mareths/suisTesAbeilles/README.md

# suisTesAbeilles

Adresse du Trello: [https://trello.com/b/HOREakGQ/suistesabeilles](https://trello.com/b/HOREakGQ/suistesabeilles)
