mareths/suisTesAbeilles/Fritzing/SuisTesAbeilles_bb.jpg

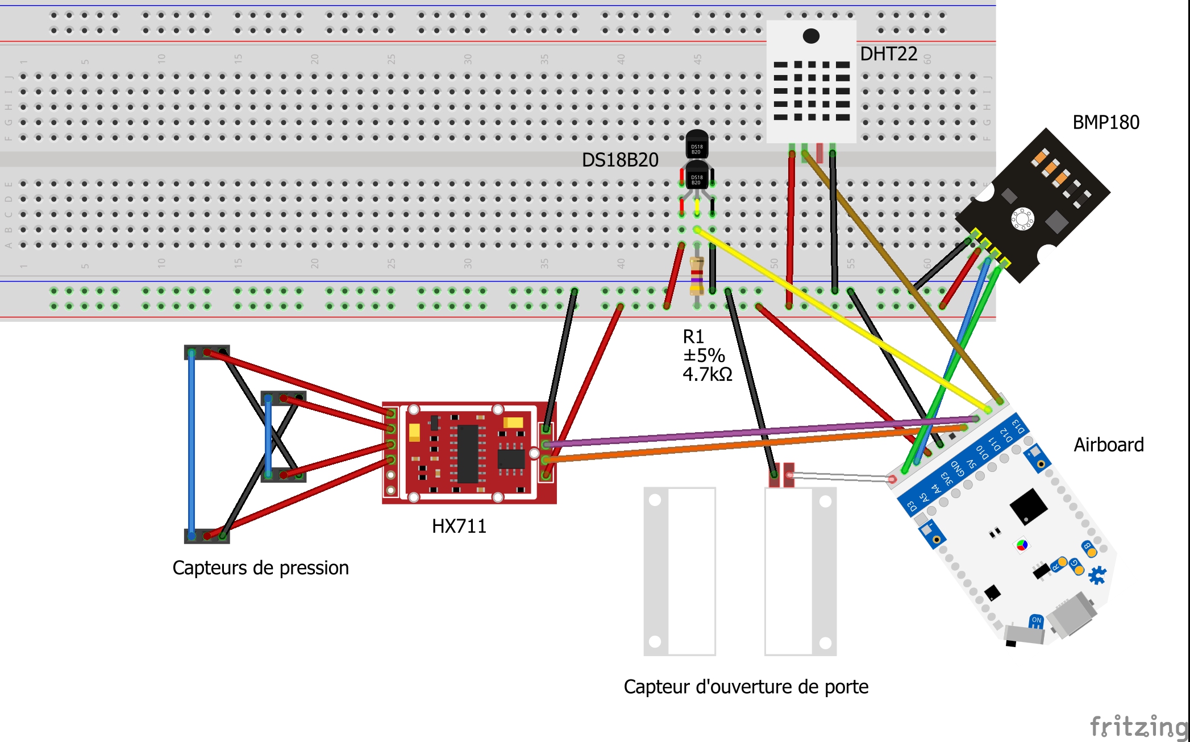
Fritzing/SuisTesAbeilles_bb.jpg
