mareths/suisTesAbeilles/sources/example/nRF24L01+/pingPong/nRF24L01+_bb.jpg

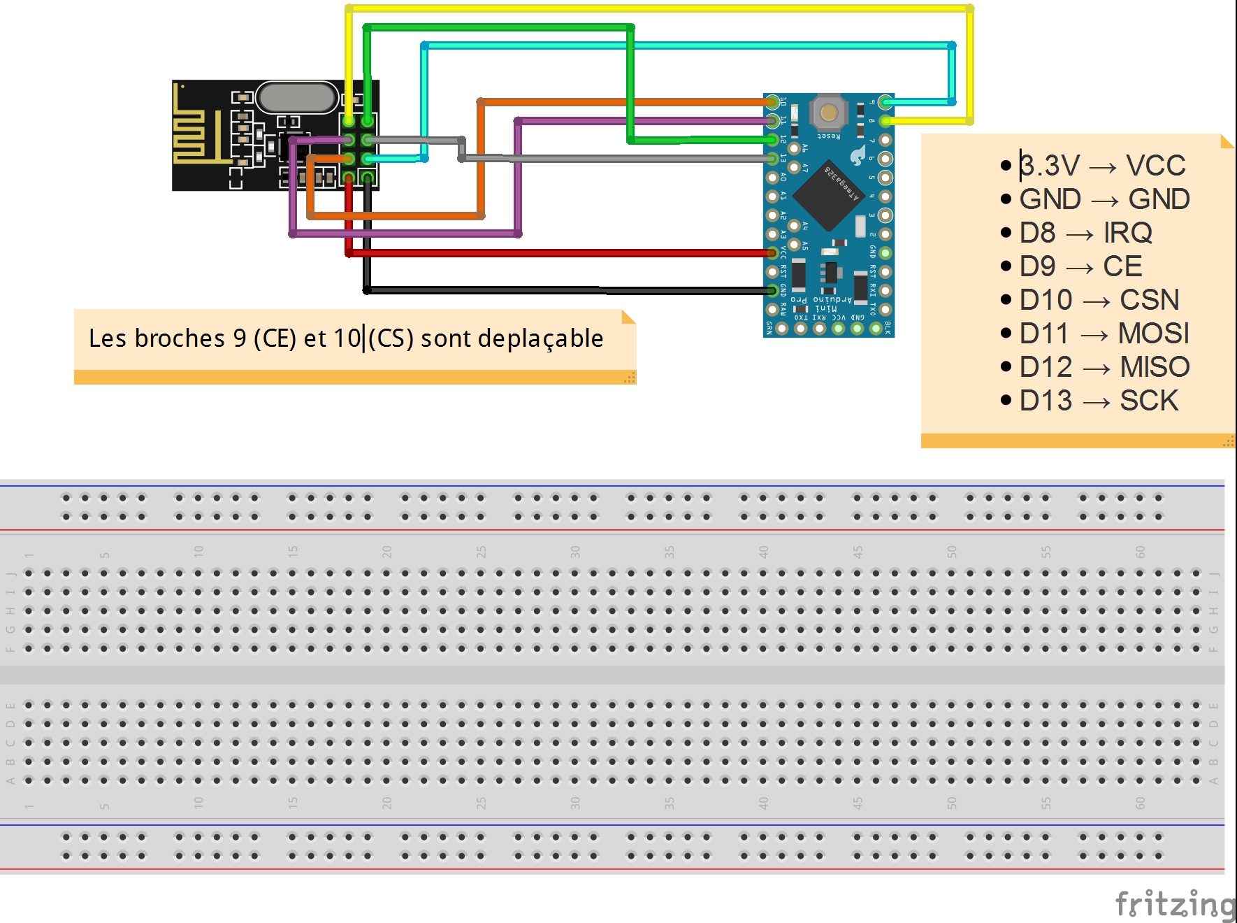
sources/example/nRF24L01+/pingPong/nRF24L01+_bb.jpg
