mareths/suisTesAbeilles/(threads)

Thread 1 (2016-10-16):

Ajouter les reférences des composants dans le schéma

mareths, 2016-10-16:
Il faudrait ajouter les références des composants dans le schéma Fritzing

mareths, 2016-10-16:
Ajout d'un peu plus d'infos sur les composants, à valider :)

ouvriere, 2016-10-16:
validé! Parfait, Champion!

Closed 2016-10-16.

Thread 2 (2016-10-16):

Pins inexactes dans le fichier poids_4LC.ino

mareths, 2016-10-16:
Dans le fichier [poids_4LC.ino](https://github.com/mareths/suisTesAbeilles/blob/master/sources/poids/poids_4LC.ino), peux-tu adapter les 2 pins en entrés aux pins Digital 10 et 11 conformément au schéma de câblage.

ouvriere, 2016-10-16:
programme modifié pour correspondre au schema

Closed 2016-10-16.

Thread 4 (2016-10-30):

Temperature negative

ouvriere, 2016-10-30:
est ce que c bien pris en compte sur l'ensemble des capteurs?

mareths, 2016-10-30:
Evolution à prendre en compte:
Pour le byte décrivant la partie entière de la température, n'utiliser que les 7 bits les plus à droite pour la valeur, et le 8ème bit le plus à gauche pour la partie négative ou positive de la température (1 = positif, 0 = négatif)

Dans le codec de décodage, trouver une formule, un algo permettant la bonne interprétation de cette température

mareths, 2016-11-11:
Test a réaliser:
Mettre Airboard+Lora+un capteur de température dans un congel, relever la T° au moment de la mesure, et relever la mesure reçue par la plateforme

ouvriere, 2016-11-12:
test fait, les capteurs rapportent une température négative.
cf dashboard 11h55

Closed 2016-11-12.

Thread 5 (2016-10-30):

detections des ds18b20 hors boot

ouvriere, 2016-10-30:
il serait bien que la détection des capteurs soit fait à chaque transmission de données?

mareths, 2016-10-30:
Comprends pas :(

ouvriere, 2016-10-30:
le soucis c que si un capteur est mal connecte, si on le reconnecte, il n est pas detecte, aucune mesure de remonte.
Il faut rebooter l arduino. docn j imagine qu il serait peut etre mieux de faire de detection a chaque prise de mesure... c couteux?

mareths, 2016-11-11:
Je pense que c'est coûteux, mais ça se tente.
Pour rester propre, on va coder une fonction reset qui refait l'init des capteurs seulement (voir le module Lora ?)
On garde la fonction setup pour la premiere initialisation.
Il faudra vérifier que ces re-init sont robustes au rejeu pour chaque capteurs

ouvriere, 2016-11-12:
je te propose de laisser tomber et de reouvrir si vraiment il y a un soucis lors de l exploitation.

Thread 6 (2016-10-30):

ds18b20 absent mais capture des mesures qd meme

ouvriere, 2016-10-30:
Done
Unable to find address for Device 2
Go to sleep
[...]
DS18B20 sensor - temperatureDS18B20_1: 2075 - 8 27
DS18B20 sensor - temperatureDS18B20_2: 2100 - 8 52
DS18B20 sensor - temperatureDS18B20_3: 2100 - 8 52

mareths, 2016-10-30:
Il y a juste 3 capteurs DS18B20, et le programme téléverser est identique à celui de la branche master ?

mareths, 2016-10-30:
C'est toujours le device 2 qui donne pas son adresse ? Il faudrait televerser le programme en mode ds18b20_1 (decommente en début de programme le define correspondant et commenté le define ds18b20_3) puis ne l'exécuter qu'avec une des 3 spndss

ouvriere, 2016-10-30:
le use case: j ai deux capteurs de connectés mais 3 dans le code. Forcement, un des 3 ne doit rien renvoyer.
1- c est le 2 qui n est pas détecté (donc 1 et 3 sont détectés), on s attend plutot à 1 et 2 et 3 non detecté (mais c pas ce qui me gêne)
2 - qd, il y a deux capteurs physique de connectés mais le code remonte des mesures pour les 3 capteurs, pourquoi il n y en a pas un sur les 3 capteurs à 0?

mareths, 2016-11-11:
Il faut flaguer les ds18b20 à "détecté" ou "absent" au moment de l'appel à **sensors.getAddress**, et lors de la collecte des la température, fixer celle-ci à "100" pour ceux qui n'ont pas été détecté.

mareths, 2016-11-14:
Ca compile, à tester

ouvriere, 2016-11-15:
ca marche

Closed 2016-11-15.

Thread 7 (2016-10-30):

bpm180 ne repond pas -> prog ko

ouvriere, 2016-10-30:
l initialisation ou la collecte des données bloque si le capteur ne repond pas

mareths, 2016-10-30:
dans le setup(), après:

```
// ---------------------------------------------------------------------
// BMP180 init
// ---------------------------------------------------------------------

    Wire.begin();
    bmp180.calibration();

```
peux-tu rajouter un

`delay(10000)`

ouvriere, 2016-11-06:
ca ne change rien

Thread 8 (2016-10-30):

Ajout des codecs objenious

mareths, 2016-10-30:
Il faudrait ajouter les codecs créés dans objenious, dans un répertoire "code", avec un sous repetoire par codec, contenant le json, et un fichier readme.txt décrivant le reste de la conf pour ce codec.

Lors d'ouverture d'issue concernant les codecs, nous pourrons ainsi les référencer, et faire un peu de ménage sur la plateforme objenious.

Closed 2016-11-12.

Thread 10 (2016-11-07):

urgent : récuperer le niveau de la batterie

ouvriere, 2016-11-07:
mettre à jour le code pour que le niveau de batterie remonte dans les métriques

ouvriere, 2016-11-11:
code modifié, a vérifier...

mareths, 2016-11-14:
Ton code ne prends pas en compte __AVR_ATmega328P__ qui correspond à l'arduino UNO et apparemment le airboard aussi
Source:
http://electronics4dogs.blogspot.fr/2011/01/arduino-predefined-constants.html
https://www.seeedstudio.com/The-AirBoard---prototyping-platform-For-IoT-p-2602.html#

mareths, 2016-11-14:
Peux-tu tester avec ce code ?
http://arduino.stackexchange.com/questions/23526/measure-different-vcc-using-1-1v-bandgap

ouvriere, 2016-11-15:
en cours de test

mareths, 2016-11-15:
A retester

ouvriere, 2016-11-16:
en cours de test
ca semble remonter la meme valeur que precedemment
une led verte s allume lors de la prise de mesure.

ouvriere, 2016-11-27:
au voltmètre
sur broche 3.3v: 2.92v
sur la broche 5v: 3.22v
sur la batterie: 3.81v

ouvriere, 2016-11-27:
avec la fct theairboard 3.19v

Thread 11 (2016-11-09):

allumage de diodes a l initialisation de programme

ouvriere, 2016-11-09:
sans debug, il est compliqué de savoir si le module a accroche le reseau, si le programme est bloque ou s il s est correctement initialise.
il faudrait au minimum une diode pour dire que le module est connecte au reseau
une diode pour la fin de l initialisation sans erreur du programme

ouvriere, 2016-11-11:
code modifié,
1 lumiere verte si connecté au reseau
1 lumiere rouge si non connecté au reseau
1 lumiere verte si setup ok

Closed 2016-11-11.

Thread 15 (2016-11-09):

dependance de la lib dht22 v1.3.0

ouvriere, 2016-11-09:
si on utilise la version 1.3.0 de la lib pour le dht22, il faut la libraire commune
https://github.com/adafruit/Adafruit_Sensor
a documenter dans le code

ouvriere, 2016-11-11:
doc ajoute dans le .ino

Closed 2016-11-11.

Thread 17 (2016-11-12):

intégrer un capteur de vibration

ouvriere, 2016-11-12:
afin de capteur les vibrations des abeilles pour en tirer un "état d'esprit" de la colonie.

mareths, 2016-11-12:
Capteur sonore plutôt non ?

Qu'elle est le type de données envoyés du coup ? Il ne faut pas que cela soit trop lourd à rentrer dans le message.

"l'état d'esprit" de la colonie est-il variable au cours de la journée ? faudra-t-il réaliser plus de mesures que ce qui est actuellement prévue (4/jours) pour avoir cette données ? (eventuellement, remonter l'info à part des autres données collectées).

A rajouter quand on passera sur un arduino mini pro, avec plus d'entrée, car là on est full :)

ouvriere, 2016-11-12:
peut être, sonore, on risque d avoir les bruits parasite de la nature...
sous forme de fréquence Hertz.
oui, il peut l être. par exemple causé par un dérangement, s il est ponctuel, pas trop de soucis, s il dure c plus grave, déduction d'une colonie en stresse.
même fréquence, quelques fois dans la journée. je pense globalement à toutes les 2 heures (versus 4/J), tant que ça rentre dans la taille du message, dans la fréquence.

Thread 18 (2016-11-12):

id inconnus qui remontent

ouvriere, 2016-11-12:
cf kibana des messages arrivent avec un id inconnu et qui peut etre négatifs....... ca sort d où???
si cette nuit ca tourne, ca signifie que ce n est pas dû à une décharge de la batterie

ouvriere, 2016-11-19:
depuis que la frequence d envoi des messages a été diminuée, le phenomene n apparait plus.

Closed 2016-11-19.

Thread 19 (2016-11-12):

améliorer l'intégration d'une nouvelle métrique

ouvriere, 2016-11-12:
Lorsque j ai du ajouter la metrique pour la batterie, j ai du incrementer chaque msg[x] de toutes les métriques car j ai du l ajouter en premiers. les derniers sont pour les ds18b20 et selon le nombre, le tableau change de grandeur. il a fallu une certaine rigueure...
il faudrait améliorer le code pour ajouter la métrique à la fin et limiter l'impact dans le code et les autres métriques.

mareths, 2016-11-12:
J'ai une piste pour générer le code automatiquement, que je dois étudier ;)

Thread 20 (2016-11-15):

Utiliser le downlink pour récupérer les mesures à la demande

ouvriere, 2016-11-15:

ouvriere, 2016-11-16:
Entre deux tempos, on voudrait peut être récupérer un lot de mesure, a un instant t, a la demande. On enverrait un downlink (via le site d'objenious) afin de reveiller l airboard pour qu'il envoie le lot.
De plus, possible d envoyer un downlink qui reinitialiserait l airboard, un reboot?

Thread 21 (2016-11-16):

lors du demarrage, envoyer un premier paquet de mesures

ouvriere, 2016-11-16:
lorsqu on demarre l airboard ou qu il y a une initialisation, il faudrait envoyer un premier lot de mesure.
ca permet de valider que c opérationnel, d avoir immediatement un premier lot d indicateurs au lieu d attendre la premiere tempo qui peut etre de plusieurs heures.

mareths, 2016-11-20:
A tester

ouvriere, 2016-11-26:
testé ok

Closed 2016-11-26.

Thread 22 (2016-11-16):

memoire faible lorsque l on active le debug

ouvriere, 2016-11-16:
depuis l insertion du code pour l issue #6 .
je copierais le message exact la prochaine fois.

mareths, 2016-11-19:
On va être limité en termes de fonctionnalités, va falloir faire des concessions :)
Je vais regarder pour optimiser le code, faudrait voir si il existe pas d'autres librairies pour les différents composants moins lourdes

Thread 23 (2016-11-19):

aucune donnée remontée depuis presque 24h, diode verte clignotante

ouvriere, 2016-11-19:
aucune données remontées depuis 11h55 hier le 18/11. pas de log sur la console objenious.
une led verte clignotée sur l airboard.
Arret/relance de l airboard effectué à 9h18. la diode ne clignote plus. Trace de logs dans la console objenious. en attente de reception d'une donnée (environ 1h apres l'A/R)
Une idée?

ouvriere, 2016-11-19:
donnees envoyées par l airboard a 10h19.
le codec du capteur dans la console objenious a été modifié en "kit de dev" -> le payload n a pas ete decode -> message non renvoyé vers notre serveur grafana/kibana.
ca fait la seconde fois que je contaste cette modif au niveau du codec -> envoyer un mail a objenious!
Reste que "une idee pour la diode clignotante?"

ouvriere, 2016-11-19:
suite au reboot de 10h19, sur 6 envoies de metriques, on en a perdu 2 (trou de deux heures dans les graphes).
rollback sur le code pour le niveau de la batterie, mis en commentaire du code theairboard et decommenté le code du lien envoyé via la messagerie instantanée. la diode verte ne clignote plus.
toujours des problemes de reception des metriques.
3.8v au voltemetre de la batterie.
reboot a 15:52: 2 paquets de metriques, puis plus rien depuis 16:53 (paquet numero 3)...
pour test capteur d ouverture activé a 18h22: paquet numero 5, on a encore perdu un paquet!
Ca commence a me gonfler!

ouvriere, 2016-12-10:
probleme de couverture reseau, resolu

Closed 2016-12-10.

Thread 25 (2016-11-20):

lorsque l on active le capteur d ouverture x messages sont envoyés au lieu de 1

ouvriere, 2016-11-20:
le nombre de message envoyé pour le capteur d ouverture est de plusieurs alors que l on voudrait 1 seul.
ou 1 seul dans un certain laps de temps.

mareths, 2016-11-20:
Capteur trop sensible, j’avais ça pendant le codage: dès que tu l'ouvrais, si tu le faisais pas assez vite, ça envoyait plein de message.
J'ai limité cela en ne faisant l'envoi des messages qu'à l'ouverture...
Faudra gérer la répétition de message plutôt coté back.
T'en penses quoi ?

ouvriere, 2016-11-20:
pas sur que cote back on puisse le faire...
on ne peut pas mettre un delay quelque part...? ou un timer par rapport à l'id?
Si ce n est pas simple a faire dans le code, remets en evol et on fera avec, je supprimerais les 10aine de mails qui arrivent ;)

mareths, 2016-11-20:
delay marche pas, déjà tenté :p
Faudrait vraiment voir avec un autre capteur de porte, je pense que c'est vraiment du à la sensibilité du truc, un coup ça envoyé le message comme il fallait, puis quelques minutes plus tard ça faisait n'importe quoi, sans changer le code
J'ai cru à un moment que ça venait des fils, qui se deconnectaient sur le breadboard...

Thread 27 (2016-12-09):

le dht22 donne une valeur de temperature avec du retard

ouvriere, 2016-12-09:
il semblerait que le capteur dht22 envoie une valeur qui correspond a la precedente valeur, par exemple, il fait 12 degres à 12h et 8 degres a 17h, a 17h on recevra 12 degres... cf grafana pour comprendre encore mieux

ouvriere, 2016-12-10:
modif du code pour prendre deux mesures avec un delais de 2s entre...

Closed 2016-12-10.

Thread 28 (2016-12-10):

(a valider) poc cluster : detecter automatiquement l ajout d un membre

ouvriere, 2016-12-10:
lorsqu un cluster est deja en place, il faudrait que le recepteur et le nouvel emetteur puisse communiquer ensemble sans que le code de du recepteur change. Le code de l emetteur doit rester equivalent ou proche du code des autres emetteurs.

Thread 29 (2016-12-10):

(a valider) poc cluster : insérer une cle d'authentification

ouvriere, 2016-12-10:
utiliser une clef d'authentification, le recpeteur n acceptera pas de message d'un emetteur n'ayant pas la clef d'authentification valide.
securite supplementaire
avoir plusieurs clusters sur un meme site ou proche

Thread 33 (2016-12-11):

integrer un capteur d'humidité exterieur

ouvriere, 2016-12-11:
afin d avoir un différentiel entre l intérieure et l extérieure de la ruche.
il faudrait un capteur qui réunisse, pression atmospherique, temperature et hygrometrie

mareths, 2016-12-11:
https://www.amazon.fr/dp/B01MQQDP8D/ref=sr_1_14?ie=UTF8&qid=1481485812&sr=8-14&keywords=BME280
https://www.generationrobots.com/fr/402249-capteur-de-pression-humidit%C3%A9-et-de-temperature-adafruit-bme280.html

ouvriere, 2016-12-11:
3 de ce type de commandés, on verra, a noter, fonctionne en spi:
https://www.amazon.fr/LANMU-CJMCU-280-Temp%C3%A9rature-barom%C3%A9trique-num%C3%A9rique/dp/B01G4T88VS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

ouvriere, 2016-12-25:
commit du schema et du code pour le bme280, a integrer en lieu et place du bmp180

Closed 2016-12-25.

Thread 34 (2016-12-17):

Mesurer la consommation pour améliorer l'autonomie

ouvriere, 2016-12-17:
en mesurant la consommation du courant lors de la prise de mesure et pendant la veille, on pourra en déduire la consommation sur une journée et estimer le temps de décharge d une batterie.
On pourra constater le bénéfice de la veille et on pourra peut être l'améliorer.

ouvriere, 2017-01-14:
Validé

Thread 35 (2016-12-18):

envoyer un lot de metrique que si les differences avec le precedent est significatif

ouvriere, 2016-12-18:
par exemple, envoyer un message que si:
la température extérieure a une différence de 0.5 degré avec la précédente mesure, et que la pression atmosphérique a une différence de 5hpa, la batterie a une différence de 0.1V etc...
ou alors on transmet que les métriques qui ont une différence selon un certain seuil (exemple, comme précédemment).

Thread 36 (2016-12-18):

RF24 ou RF24Network?

ouvriere, 2016-12-18:
le premier,c est un récepteur pour 6 émetteurs max.
le second est peut être plus lourd a embarquer, adapté pour s’intégrer avec d autres modules radios (cf domotique domestique).
Lequel va t-on utiliser?

Thread 37 (2017-01-11):

Envoi de messages plus rapidement à l'init du module

mareths, 2017-01-11:
Afin d’être sur que tout fonctionne correctement après avoir allumé le module, et l'avoir disposé sur la ruche, nous souhaitons envoyé les premiers messages sur un intervalle de temps plus court, afin d’être sur que tout fonctionne correctement sans attendre plusieurs heures avant de recevoir le message suivant.

mareths, 2017-01-11:
https://github.com/mareths/suisTesAbeilles/commit/8ad9d87cfdd4dc437c4fc74a8fc8d5d5ca5225af

ouvriere, 2017-01-14:
installée
evol essentielle!

Closed 2017-01-14.
