mareths/suisTesAbeilles/(list of files, drawings)

Other design files:
Fritzing/SuisTesAbeilles.fzz
sources/example/BME280/BME280.fzz
sources/example/nRF24L01+/pingPong/nRF24L01+.fzz
