mareths/suisTesAbeilles/(commit log)

2016-10-10 Ajout librairie et premier schema de montage
    [SuisTesAbeilles.fzz]
2016-10-16 Utilisation de l'airboard
    [SuisTesAbeilles.fzz]
2016-10-16 Ajout du capteur d'ouverture de porte
    [SuisTesAbeilles.fzz]
2016-10-16 Correction position resistance pour les DS18B20
    [SuisTesAbeilles.fzz]
2016-10-16 ajout du prog pour la balance
2016-10-16 ajout de la lib hx711 et modif des pins dans le prog pour correspondre au schema
2016-10-16 modif des pins dans le prog pour correspondre au schema
2016-10-16 ajout de la llibrairie HX711
2016-10-16 inversion A4 et A5 pour le BMP180
    [SuisTesAbeilles.fzz]
2016-10-16 Ajout des repertoire pour les autres capteurs
2016-10-16 Mise à jour Issue : Ajouter les reférences des composants dans le schéma
    [SuisTesAbeilles.fzz]
2016-10-16 Code pour le capteur d'ouverture, avec mecanisme de reveil toutes les minutes pour simuler l'envoi de données
2016-10-16 ajout de la variable nbMinuteTimeout pour définir la durée en minutes du timeout
2016-10-17 Ajouts des couleurs de fils pour le ds18b20, remaniement du schéma pour les ds18b20, passage de la résistance à 4.7k
    [SuisTesAbeilles.fzz]
2016-10-17 Ajout du code source pour les ds18b20
2016-10-17 correction etiquette ds18b20
    [SuisTesAbeilles.fzz]
2016-10-17 Ajout de la librairie pour le BMP180
    [SuisTesAbeilles.fzz]
2016-10-17 Changement de l'etiquette pour le BMP180
    [SuisTesAbeilles.fzz]
2016-10-18 re-organisation des sources
2016-10-20 Ajout de l'option de compilation DEBUG
2016-10-20 Ajout du mode IDLE et du capteur d'ouverture de porte
2016-10-20 Correction multiple 100 pour temperatureDHT22
    [suisTesAbeilles.ino]
2016-10-23 ajout du capteur de poids dans le main sketch
2016-10-24 Ajout des sondes DS18B20 dans le main sketch
2016-10-25 modification du type de message envoyé a Objenious en fonction du nombre de DS18B20\nrenommage des variables de DS18B20
2016-10-25 ajout d'option de compilation pour la partie capteur de poids
2016-11-09 modif variable pressure en long int pour obtenir la bonne avleur
2016-11-11 correction du code pour: le msg[0] correspondant à l'id est toujours à 1 documentation dependance de la lib dht22 v1.3.0 le tare de la balance ne se fait pas correctement allumage de diodes a l initi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
    [suisTesAbeilles.ino]
2016-11-11 ajout de la licence
2016-11-12 ajout des fichiers de codecs
2016-11-14 correction : ds18b20 absent mais capture des mesures qd meme
    [suisTesAbeilles.ino]
2016-11-15 Add files via upload
    3v pour le bpm180
    suppression de la resistance pour le dht22
    [SuisTesAbeilles.fzz]
2016-11-15 Delete SuisTesAbeilles.fzz
    zut
    [SuisTesAbeilles.fzz]
2016-11-15 Add files via upload
    suppression de la résistance pour le dht22
    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
    [SuisTesAbeilles.fzz]
2016-11-15 suppression de la resistance pour le dht22, 3v pour le bpm180
2016-11-15 modification du code pour les relevé de batterie
2016-11-20 lors du demarrage, envoyer un premier paquet de mesures
2016-12-10 modification mesure batterie modif de la prose de mesure du dht22 pour eviter le retard
2016-12-11 message toutes les 3 heures
2016-12-18 ajout exemple RF24, en se basant sur l exemple de la lib+schéma
    [nRF24L01+.fzz]
2016-12-18 deplacement de l exemple dans pingpong
    [nRF24L01+.fzz]
2016-12-25 ajout du capteur bme280
    [BME280.fzz]
2017-01-11 Correction issue #37
    initTimerDone: définit le nombre de message que l'on souhaite recevoir plus rapidement, apres allumage du module
    nbMinuteTimeout est définit sur une période plus courte, afon d'envoyer les premiers messages plus rapidement
    nbMinuteTimeoutAfterInitTimer donne l'intervalle de temps entre les messages une fois que l'envoi des messages a été controlé
    [suisTesAbeilles.ino]
